tanguy-rdt/depot-ensta-weather-station/(list of files, drawings)

Other design files:
Arduino/proteus/routage/PROTEUS_TanguyROUDAUT_TomALLAIN.pdsprj
Arduino/proteus/simu/Simul Mega328bis.pdsprj
