tanguy-rdt/depot-ensta-weather-station/(commit log)

2022-07-03 add web ui for esp32
2022-07-03 Add proteus project for simul sensor board
    [Simul Mega328bis.pdsprj]
2022-07-04 Add Si7034 library for server board
2022-07-04 Start DS1307 library for server board
2022-07-04 Add DS1307 lib for server board
2022-07-05 Refacto sensor board to platformio project
2022-07-05 Refacto server board to platformio project
2022-07-05 End(Maybe) of the server board without lora, need test
2022-07-05 Sensor board without lora and bmp pressure broken, need test
    [main.cpp]
2022-07-05 Add info box in main of server board
2022-07-09 Bugfix date of ds1307, si7034, change delay of request on webui and get power level on sensor board
    [main.cpp]
2022-07-10 Add Lora for sensor board, need test
